openwch/RISC-V_ESC/docs/SCH_AM32_V203F8U6.pdf

# 焊盘ADC_V

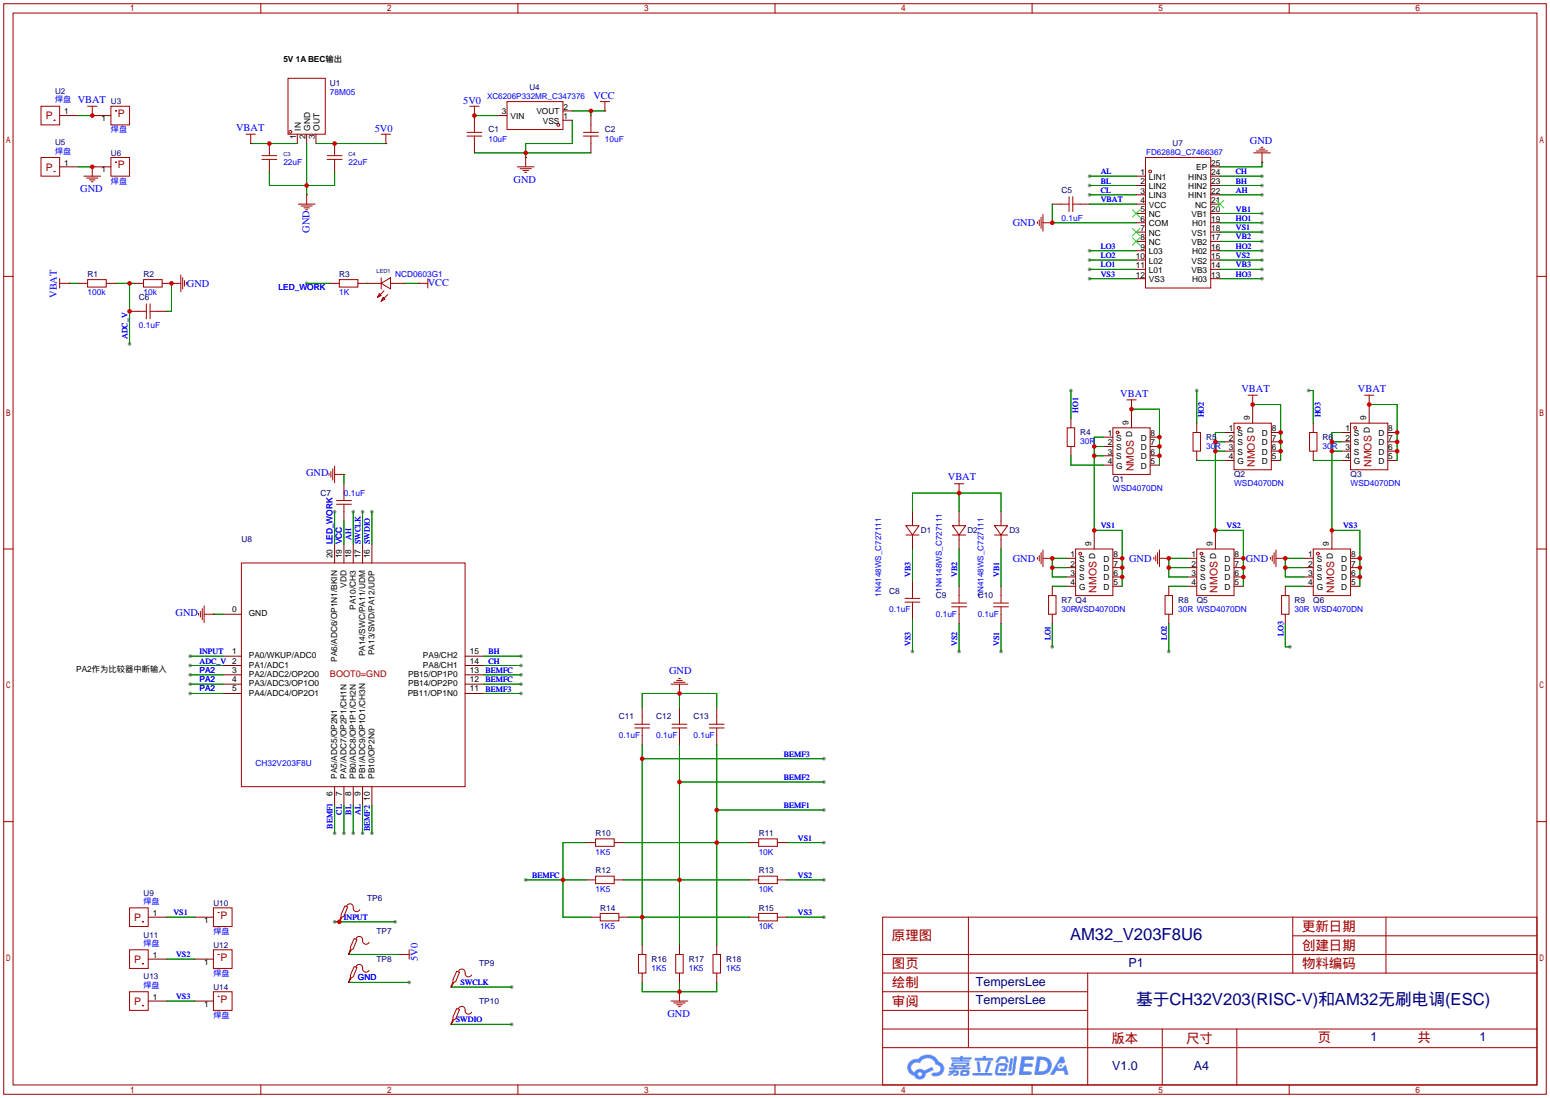
[picture p15: page 1]
