openwch/RISC-V_ESC/GPIO/GPIO_Toggle/User/Src/signal.c

/*
 * IO.c
 *
 *  Created on: Sep. 26, 2020
 *      Author: Alka
 */

#include "targets.h"
#include "signal.h"
#include  "IO.h"
#include "dshot.h"
#include "serial_telemetry.h"
#include "functions.h"
#include "sounds.h"
#include "common.h"

int max_servo_deviation = 250;
int servorawinput;

uint8_t enter_calibration_count = 0;
uint8_t calibration_required = 0;
uint8_t high_calibration_counts = 0;
uint8_t high_calibration_set = 0;
uint16_t last_high_threshold = 0;
uint8_t low_calibration_counts = 0;
uint16_t last_input = 0;



void computeMSInput(){

	int lastnumber = dma_buffer[0];
	for ( int j = 1 ; j < 2; j++){

		if(((dma_buffer[j] - lastnumber) < 1500) && ((dma_buffer[j] - lastnumber) > 0)){ // blank space

			newinput = map((dma_buffer[j] - lastnumber),243,1200, 0, 2000);
			break;
		}
		lastnumber = dma_buffer[j];
	}
}


void computeServoInput(){
//        printf("%d %d %d\r\n",dma_buffer[0],dma_buffer[1],dma_buffer[2]);
		if(((dma_buffer[1] - dma_buffer[0]) >800 ) && ((dma_buffer[1] - dma_buffer[0]) < 2200)){
		if(calibration_required){
			if(!high_calibration_set){
			if(high_calibration_counts == 0){
				last_high_threshold = dma_buffer[1] - dma_buffer[0];
			}
			high_calibration_counts ++;
			if(getAbsDif(last_high_threshold, servo_high_threshold) > 50){
				calibration_required = 0;
			}else{
			servo_high_threshold = ((7* servo_high_threshold + (dma_buffer[1] - dma_buffer[0])) >> 3);
			if(high_calibration_counts > 50){
				servo_high_threshold =  servo_high_threshold - 25;
				eepromBuffer[33] = (servo_high_threshold - 1750)/2;
				high_calibration_set = 1;
				playDefaultTone();
			}
			}
			last_high_threshold = servo_high_threshold;
			}
			if(high_calibration_set){
				if(dma_buffer[1] - dma_buffer[0] < 1250){
				low_calibration_counts ++;
				servo_low_threshold = ((7*servo_low_threshold + (dma_buffer[1] - dma_buffer[0])) >> 3);
				}
				if(low_calibration_counts > 75){
					servo_low_threshold = servo_low_threshold + 25;
					eepromBuffer[32] = (servo_low_threshold - 750)/2;
				calibration_required = 0;
				saveEEpromSettings();
				low_calibration_counts = 0;
				playChangedTone();
				}
			}
			signaltimeout = 0;
		}else{
			if(bi_direction){
				if(dma_buffer[1] - dma_buffer[0] <= servo_neutral){
				servorawinput = map((dma_buffer[1] - dma_buffer[0]), servo_low_threshold, servo_neutral, 0, 1000);
				}else{
				servorawinput = map((dma_buffer[1] - dma_buffer[0]), servo_neutral+1, servo_high_threshold, 1001, 2000);
				}
			}else{
			servorawinput = map((dma_buffer[1] - dma_buffer[0]), servo_low_threshold, servo_high_threshold, 47, 2047);
			if(servorawinput == 47){
				servorawinput = 0;
			}
			}
			signaltimeout = 0;
		}
		}else{
			zero_input_count = 0;      // reset if out of range
		}

	if (servorawinput - newinput > max_servo_deviation){
		newinput += max_servo_deviation;
	}else if(newinput - servorawinput > max_servo_deviation){
		newinput -= max_servo_deviation;
	}else{
		newinput = servorawinput;
	}

}
extern uint16_t dshot_badcounts;
void transfercomplete()
{
	if(armed && dshot_telemetry)
	{
	    if(out_put)
	    {
	        receiveDshotDma();
	        return;
	    }
	    else
	    {
			sendDshotDma();
			make_dshot_package();
		    computeDshotDMA();
		    return;
	    }
	}
	if(inputSet == 0)
	{
//	    PRINT("detect\r\n");
	    detectInput( );
	 	receiveDshotDma();
	 	return;
	}

	if (inputSet == 1)
	{
	    if(dshot_telemetry)
	    {
	        if(out_put)
	        {
	            //    	TIM17->CNT = 0;
	            make_dshot_package();          // this takes around 10us !!
	            computeDshotDMA();             //this is slow too..
	            PRINT("3:%d %d\r\n",newinput,dshot_badcounts);
	            receiveDshotDma();             //holy smokes.. reverse the line and set up dma again
	            return;
	        }
	        else
	        {
	            sendDshotDma();
	            return;
	        }
	    }
	    else
	    {
	        if (dshot == 1)
	        {
	            computeDshotDMA( );
	            if(send_telemetry)
	            {
	                // done in 10khz routine
	            }
	            receiveDshotDma();
	            PRINT("2:%d %d\r\n",newinput,dshot_badcounts);
	        }
	        if(servoPwm == 1)
	        {
	            if( !(INPUT_PIN_PORT->INDR & INPUT_PIN))
	            {  // if the pin is low
	                computeServoInput();
	                PRINT("1:%d\r\n",newinput);
	            }
	            MODIFY_REG(IC_TIMER_REGISTER->CCER,(0x3<<(4*IC_TIMER_CHANNEL)),(0x1<<(4*IC_TIMER_CHANNEL)));// setup rising pin trigger.
	            receiveDshotDma( );
	            INPUT_DMA_CHANNEL->CFGR  |= (0x1<<2);
	        }

	    }
	    if(!armed)
	    {
	        if (adjusted_input < 0)
	        {
	            adjusted_input = 0;
	        }
	        if (adjusted_input == 0 && calibration_required == 0){                       // note this in input..not newinput so it will be adjusted be main loop
	            zero_input_count++;
	 		}
	        else
	        {
	            zero_input_count = 0;
	            if(adjusted_input > 1500)
	            {
	                if(getAbsDif(adjusted_input, last_input) > 50){
	                    enter_calibration_count = 0;
	                }
	                else{
	                    enter_calibration_count++;
	                }

	                if(enter_calibration_count >50 && (!high_calibration_set)){
	                    playBeaconTune3();
	                    calibration_required = 1;
	                    enter_calibration_count = 0;
	                }
	                last_input = adjusted_input;
	            }
	        }
	    }
	}
}
