openwch/RISC-V_ESC/GPIO/GPIO_Toggle/User/Src/dshot.c

/*
 * dshot.c
 *
 *  Created on: Apr. 22, 2020
 *      Author: Alka
 */

#include "functions.h"
#include "dshot.h"
#include "targets.h"
#include "common.h"
#include "sounds.h"

int dpulse[16] = {0} ;

const char gcr_encode_table[16] = { 0b11001,
		0b11011,
		0b10010,
		0b10011,
		0b11101,
		0b10101,
		0b10110,
		0b10111,
		0b11010,
		0b01001,
		0b01010,
		0b01011,
		0b11110,
		0b01101,
		0b01110,
		0b01111
};

char EDT_ARM_ENABLE = 0;
char EDT_ARMED = 0;
int shift_amount = 0;
uint32_t gcrnumber;
extern int e_com_time;
extern int zero_crosses;
extern char send_telemetry;
extern int smoothedinput;
extern uint8_t max_duty_cycle_change;
int dshot_full_number;
extern char play_tone_flag;
uint8_t command_count = 0;
uint8_t last_command = 0;
uint8_t high_pin_count = 0;
uint32_t gcr[37] =  {0};
volatile uint16_t dshot_frametime;
uint16_t dshot_goodcounts;
uint16_t dshot_badcounts;
char dshot_extended_telemetry = 0;
uint16_t send_extended_dshot = 0;


void computeDshotDMA()
{
    int j = 0;
    dshot_frametime = dma_buffer[31]- dma_buffer[0];


//for(int m=0;m<32;m++)
//{
//    if((m!=0) && (m%2 == 0)) PRINT("\n");
//    PRINT("%d ",dma_buffer[m]);
//    if((m%2) ==1) PRINT("%d ",dma_buffer[m]-dma_buffer[m-1]);
//}
//PRINT("\r\n");
//PRINT("flen:%d\r\n",dshot_frametime);


#if defined(MCU_V203F8)
             if((dshot_frametime < 1350 ) &&(dshot_frametime > 1150))
             {
                for (int i = 0; i < 16; i++)
                {
                    dpulse[i] = ((dma_buffer[j + (i<<1) +1] - dma_buffer[j + (i<<1)])>>5) ;
                }
#endif

#if defined(MCU_F051) || defined(MCU_F031)
	         if((dshot_frametime < 1350 ) &&(dshot_frametime > 1150)){
				for (int i = 0; i < 16; i++){
					dpulse[i] = ((dma_buffer[j + (i<<1) +1] - dma_buffer[j + (i<<1)])>>5) ;
				}
#endif
#if defined(MCU_G071) || defined(MCU_GD32)
				if((dshot_frametime < 1690)&&(dshot_frametime > 1600)){
				for (int i = 0; i < 16; i++){
					dpulse[i] = ((dma_buffer[j + (i<<1) +1] - dma_buffer[j + (i<<1)])>>6) ;
				}
#endif
#if defined(MCU_L431)
				if((dshot_frametime < 1800)&&(dshot_frametime > 1650)){
				for (int i = 0; i < 16; i++){
					dpulse[i] = ((dma_buffer[j + (i<<1) +1] - dma_buffer[j + (i<<1)])>>6) ;
				}
#endif

				uint8_t calcCRC = ((dpulse[0]^dpulse[4]^dpulse[8])<<3
						|(dpulse[1]^dpulse[5]^dpulse[9])<<2
						|(dpulse[2]^dpulse[6]^dpulse[10])<<1
						|(dpulse[3]^dpulse[7]^dpulse[11])
				);
				uint8_t checkCRC = (dpulse[12]<<3 | dpulse[13]<<2 | dpulse[14]<<1 | dpulse[15]);

				if(!armed){
					if (dshot_telemetry == 0){
						 if(INPUT_PIN_PORT->INDR & INPUT_PIN){  // if the pin is high for 100 checks between signal pulses its inverted
							 high_pin_count++;
							 if(high_pin_count > 100){
								 dshot_telemetry = 1;
							 }
						 }
					}
				}
				if(dshot_telemetry){
					checkCRC= ~checkCRC+16;
				}

				int tocheck = (
						dpulse[0]<<10 | dpulse[1]<<9 | dpulse[2]<<8 | dpulse[3]<<7
						| dpulse[4]<<6 | dpulse[5]<<5 | dpulse[6]<<4 | dpulse[7]<<3
						| dpulse[8]<<2 | dpulse[9]<<1 | dpulse[10]);

				if(calcCRC == checkCRC){
					signaltimeout = 0;
					dshot_goodcounts++;
					if(dpulse[11]==1){
                    send_telemetry=1;
					}
					if (tocheck > 47){
						if(EDT_ARMED){
						newinput = tocheck;
	                    dshotcommand = 0;
	                    command_count = 0;
	                    return;
						}
					}

				if ((tocheck <= 47)&& (tocheck > 0)){
					newinput = 0;
					dshotcommand = tocheck;    //  todo
				}
				if (tocheck == 0){
					if(EDT_ARM_ENABLE == 1){
					EDT_ARMED = 0;
					}
					newinput = 0;
					dshotcommand = 0;
					command_count = 0;
				}

				if ((dshotcommand > 0) && (running == 0) && armed) {
					if(dshotcommand != last_command){
						last_command = dshotcommand;
						command_count = 0;
					}
					if(dshotcommand < 5){    // beacons
					command_count = 6;      //go on right away
					}
					command_count++;
					if(command_count >= 6){
						command_count = 0;
					switch (dshotcommand){                   // todo

					case 1:
						playInputTune();
					break;
					case 2:
						playInputTune2();
     			    break;
					case 3:
						playBeaconTune3();
					break;
					case 5:
						playStartupTune();
					break;
					case 7:
						dir_reversed = 0;
						forward = 1 - dir_reversed;
						play_tone_flag = 1;
				    break;
				    case 8:
				    	dir_reversed = 1;
				    	forward = 1 - dir_reversed;
				    	play_tone_flag = 2;
				    break;
					case 9:
						bi_direction = 0;
				    break;
					case 10:
						bi_direction = 1;
				    break;
					case 12:
					saveEEpromSettings();
					//delayMillis(100);
				//	NVIC_SystemReset();
				    break;
					case 13:
					dshot_extended_telemetry = 1;
					send_extended_dshot = 0b111000000000;
					if(EDT_ARM_ENABLE == 1){
						EDT_ARMED = 1;
					}
					break;
					case 14:
					dshot_extended_telemetry = 0;
					send_extended_dshot = 0b111011111111;
				//	make_dshot_package();
					break;
					case 20:
						forward = 1 - dir_reversed;
					break;
					case 21:
						forward = dir_reversed;
					break;

					}
 				last_dshot_command = dshotcommand;
				dshotcommand = 0;
				}
				}
				}else{
					dshot_badcounts++;
				}

		}
}



void make_dshot_package(){
if(send_extended_dshot > 0){
  dshot_full_number = send_extended_dshot;
  send_extended_dshot = 0;
}else{
  if (!running){
	  e_com_time = 65535;
  }
//	calculate shift amount for data in format eee mmm mmm mmm, first 1 found in first seven bits of data determines shift amount
// this allows for a range of up to 65408 microseconds which would be shifted 0b111 (eee) or 7 times.
for (int i = 15; i >= 9 ; i--){
	if(e_com_time >> i == 1){
		shift_amount = i+1 - 9;
		break;
	}else{
		shift_amount = 0;
	}
}
// shift the commutation time to allow for expanded range and put shift amount in first three bits
	dshot_full_number = ((shift_amount << 9) | (e_com_time >> shift_amount));

}
//calculate checksum
	uint16_t  csum = 0;
	uint16_t csum_data = dshot_full_number;
		  for (int i = 0; i < 3; i++) {
		      csum ^=  csum_data;   // xor data by nibbles
		      csum_data >>= 4;
		  }
		  csum = ~csum;       // invert it
		  csum &= 0xf;

		  dshot_full_number = (dshot_full_number << 4)  | csum; // put checksum at the end of 12 bit dshot number

// GCR RLL encode 16 to 20 bit

		  gcrnumber = gcr_encode_table[(dshot_full_number >> 12)] << 15  // first set of four digits
		  | gcr_encode_table[(((1 << 4) - 1) & (dshot_full_number >> 8))] << 10  // 2nd set of 4 digits
		  | gcr_encode_table[(((1 << 4) - 1) & (dshot_full_number >> 4))] << 5  //3rd set of four digits
		  | gcr_encode_table[(((1 << 4) - 1) & (dshot_full_number >> 0))];  //last four digits
//GCR RLL encode 20 to 21bit output
#if defined(MCU_V203F8)
          gcr[1+buffer_padding] = 64;
          for( int i= 19; i >= 0; i--){              // each digit in gcrnumber
              gcr[buffer_padding+20-i+1] = ((((gcrnumber &  1 << i )) >> i) ^ (gcr[buffer_padding+20-i]>>6)) << 6;        // exclusive ored with number before it multiplied by 64 to match output timer.
          }
          gcr[buffer_padding] = 0;
#endif
#if defined(MCU_F051) || defined(MCU_F031)
		  gcr[1+buffer_padding] = 64;
		  for( int i= 19; i >= 0; i--){              // each digit in gcrnumber
			  gcr[buffer_padding+20-i+1] = ((((gcrnumber &  1 << i )) >> i) ^ (gcr[buffer_padding+20-i]>>6)) << 6;        // exclusive ored with number before it multiplied by 64 to match output timer.
		  }
          gcr[buffer_padding] = 0;
#endif
#ifdef MCU_G071
		  gcr[1+7] = 94;
		  for( int i= 19; i >= 0; i--){              // each digit in gcrnumber
			  gcr[7+20-i+1] = ((((gcrnumber &  1 << i )) >> i) ^ (gcr[7+20-i]>>6)) *94;        // exclusive ored with number before it multiplied by 64 to match output timer.
		  }
          gcr[7] = 0;
#endif
#ifdef MCU_GD32
		  gcr[1+7] = 84;
		  for( int i= 19; i >= 0; i--){              // each digit in gcrnumber
			  gcr[7+20-i+1] = ((((gcrnumber &  1 << i )) >> i) ^ (gcr[7+20-i]>>6)) *84;        // exclusive ored with number before it multiplied by 64 to match output timer.
		  }
          gcr[7] = 0;
#endif
#ifdef MCU_L431
		  gcr[1+7] = 94;
		  for( int i= 19; i >= 0; i--){              // each digit in gcrnumber
			  gcr[7+20-i+1] = ((((gcrnumber &  1 << i )) >> i) ^ (gcr[7+20-i]>>6)) *94;        // exclusive ored with number before it multiplied by 64 to match output timer.
		  }
          gcr[7] = 0;
#endif

}
