openwch/RISC-V_ESC/GPIO/GPIO_Toggle/User/MCU/V203/Src/serial_telemetry.c

/*
 * serial_telemetry.c
 *
 *  Created on: May 13, 2020
 *      Author: Alka
 */


#include "serial_telemetry.h"
#include "targets.h"


uint8_t aTxBuffer[10];
uint8_t nbDataToTransmit = sizeof(aTxBuffer);


//PA11   USART2_TX_2
void telem_UART_Init(void)
{

  USART_InitTypeDef USART_InitStruct = {0};
  GPIO_InitTypeDef  GPIO_InitStruct = {0};
  DMA_InitTypeDef   DMA_InitStructure = {0};

  /* Peripheral clock enable */
  RCC_APB2PeriphClockCmd( RCC_APB2Periph_USART1|RCC_APB2Periph_GPIOB, ENABLE );
  GPIO_PinRemapConfig(GPIO_Remap_USART1,ENABLE);

  /**USART2 GPIO Configuration
  PB6   ------> USART1_TX_1
  */
  GPIO_InitStruct.GPIO_Pin = GPIO_Pin_6;
  GPIO_InitStruct.GPIO_Speed = GPIO_Speed_50MHz;
  GPIO_InitStruct.GPIO_Mode = GPIO_Mode_AF_PP;
  GPIO_Init(GPIOB, &GPIO_InitStruct);


  USART_InitStruct.USART_BaudRate            = 115200;
  USART_InitStruct.USART_WordLength          = USART_WordLength_8b;
  USART_InitStruct.USART_StopBits            = USART_StopBits_1;
  USART_InitStruct.USART_Parity              = USART_Parity_No;
  USART_InitStruct.USART_Mode                = USART_Mode_Tx;
  USART_InitStruct.USART_HardwareFlowControl = USART_HardwareFlowControl_None;
  USART_Init(USART1, &USART_InitStruct);
  USART_Cmd(USART1, ENABLE);

  /* USART1 DMA Init */
  DMA_DeInit(DMA1_Channel4);
  DMA_InitStructure.DMA_PeripheralBaseAddr = (uint32_t) &(USART1->DATAR);
  DMA_InitStructure.DMA_MemoryBaseAddr = (uint32_t)aTxBuffer;
  DMA_InitStructure.DMA_DIR = DMA_DIR_PeripheralDST;
  DMA_InitStructure.DMA_BufferSize = nbDataToTransmit;
  DMA_InitStructure.DMA_PeripheralInc = DMA_PeripheralInc_Disable;
  DMA_InitStructure.DMA_MemoryInc = DMA_MemoryInc_Enable;
  DMA_InitStructure.DMA_PeripheralDataSize = DMA_PeripheralDataSize_Byte;
  DMA_InitStructure.DMA_MemoryDataSize = DMA_MemoryDataSize_Byte;
  DMA_InitStructure.DMA_Mode = DMA_Mode_Normal;
  DMA_InitStructure.DMA_Priority = DMA_Priority_Low;
  DMA_InitStructure.DMA_M2M = DMA_M2M_Disable;
  DMA_Init(DMA1_Channel4, &DMA_InitStructure);



  /* (5) Enable DMA transfer complete/error interrupts  */
  DMA_ClearFlag(DMA1_FLAG_TC4|DMA1_FLAG_TE4|DMA1_FLAG_HT4);
  DMA_ITConfig(DMA1_Channel4, DMA_IT_TC|DMA_IT_TE, ENABLE);

  NVIC_SetPriority(DMA1_Channel4_IRQn, 0xE0);  //传输完成中断
  NVIC_EnableIRQ(DMA1_Channel4_IRQn);


  //USART_DMACmd(USART2,USART_DMAReq_Tx,ENABLE);
}

void send_telem_DMA()
{
    // set data length and enable channel to start transfer
      MODIFY_REG(USART1->CTLR1, 0x3<<2, 0x1<<3);  //使能发送
      DMA1_Channel4->CNTR  = nbDataToTransmit;
      DMA1_Channel4->MADDR = (uint32_t)aTxBuffer;  //DMA地址自增的，需要重新设置
      USART_DMACmd(USART1,USART_DMAReq_Tx,ENABLE);
      DMA_Cmd(DMA1_Channel4, ENABLE);
}








uint8_t update_crc8(uint8_t crc, uint8_t crc_seed){
uint8_t crc_u, i;
crc_u = crc;
crc_u ^= crc_seed;
for ( i=0; i<8; i++) crc_u = ( crc_u & 0x80 ) ? 0x7 ^ ( crc_u << 1 ) : ( crc_u << 1 );
return (crc_u);
}

uint8_t get_crc8(uint8_t *Buf, uint8_t BufLen){
uint8_t crc = 0, i;
for( i=0; i<BufLen; i++) crc = update_crc8(Buf[i], crc);
return (crc);
}


void makeTelemPackage(uint8_t temp, uint16_t voltage, uint16_t current, uint16_t consumption, uint16_t e_rpm){

  aTxBuffer[0] = temp; // temperature

  aTxBuffer[1] = (voltage >> 8) & 0xFF; // voltage hB
  aTxBuffer[2] = voltage & 0xFF; // voltage   lowB

  aTxBuffer[3] = (current >> 8) & 0xFF; // current
  aTxBuffer[4] = current & 0xFF; // divide by 10 for Amps

  aTxBuffer[5] = (consumption >> 8) & 0xFF; // consumption
  aTxBuffer[6] = consumption & 0xFF; //  in mah

  aTxBuffer[7] = (e_rpm >> 8) & 0xFF; //
  aTxBuffer[8] = e_rpm & 0xFF; // eRpM *100

  aTxBuffer[9] = get_crc8(aTxBuffer,9);
}
