openwch/RISC-V_ESC/GPIO/GPIO_Toggle/User/Inc/functions.h

/*
 * functions.h
 *
 *  Created on: Sep. 26, 2020
 *      Author: Alka
 */

#ifndef FUNCTIONS_H_
#define FUNCTIONS_H_

#include "main.h"


int getAbsDif(int number1, int number2);
void delayMicros(uint32_t micros);
void delayMillis(uint32_t millis);
long map(long x, long in_min, long in_max, long out_min, long out_max);

#endif /* FUNCTIONS_H_ */
