openwch/RISC-V_ESC/GPIO/GPIO_Toggle/User/MCU/V203/Inc/ADC.h

/*
 * ADC.h
 *
 *  Created on: May 20, 2020
 *      Author: Alka
 */

#include "main.h"
#include "targets.h"


#ifndef ADC_H_
#define ADC_H_



void ADC_DMA_Callback(void);
void enableADC_DMA(void);
void activateADC(void);
void ADCInit(void);




#endif /* ADC_H_ */
