openwch/RISC-V_ESC/GPIO/GPIO_Toggle/User/MCU/V203/Inc/IO.h

/*
 * IO.h
 *
 *  Created on: Sep. 26, 2020
 *      Author: Alka
 */

#ifndef IO_H_
#define IO_H_


#include "main.h"

void changeToOutput();
void changeToInput();
void receiveDshotDma();
void sendDshotDma();
void detectInput();




#endif /* IO_H_ */
