openwch/RISC-V_ESC/GPIO/GPIO_Toggle/User/MCU/V203/Inc/comparator.h

/*
 * comparator.h
 *
 *  Created on: Sep. 26, 2020
 *      Author: Alka
 */

#ifndef COMPARATOR_H_
#define COMPARATOR_H_
#include "main.h"

#define COMP_PA0 0b1100001
#define COMP_PA4 0b1000001
#define COMP_PA5 0b1010001

void maskPhaseInterrupts();
void changeCompInput();
void enableCompInterrupts();

extern char rising;
extern char step;


#endif /* COMPARATOR_H_ */
